Analytic-Areis/Quadrature-Down-Converter/presentation/presentation.pdf

# Design, Simulation, and Hardware Implementation of a Quadrature Down Converter

# Comprehensive Project Report & Laboratory Verification Presentation

Katta Sri Kaushik | Lakshmi Sai Bhargav V | Kushwanth Lanka

### Department of Electrical and Computer Engineering Center for VLSI and Embedded Systems Technology (CVEST) International Institute of Information Technology, Hyderabad

# May 2026

Katta, Lakshmi, Kushwanth (IIIT Hyderabad) | Quadrature Down Converter | May 2026 | 1 / 1

# Presentation Outline

Katta, Lakshmi, Kushwanth (IIIT Hyderabad) | Quadrature Down Converter | May 2026 | 2 / 1

# System Specifications & Design Constraints

# Project Performance Requirements & Directives

# Technology Node & Models: TSMC 180nm CMOS technology for

NMOS switches and UA741 operational amplifiers.

# MOSFET Parasitic Modeling: Geometric layout parameter

optimization: W , L, AS , AD, PS , PD.

# Amplifier Architecture Choice: Implemented a discrete CE BJT Amplifier stage with emitter degeneration for low-distortion output

voltage gain.

# Oscillator Target: Quadrature vOSC I & vOSC Q at 170 kHz with

90◦ phase shift and 1 Vpp swing.

# Filter & Output Spec: Cascaded LPF cutoff fc ≈ 4.65 kHz, final

amplified IF output ≥ 400 mVpp at 5 kHz.

Katta, Lakshmi, Kushwanth (IIIT Hyderabad) | Quadrature Down Converter | May 2026 | 3 / 1

# Utility & Need for Quadrature (I-Q) Operation

# Need in Wireless Receivers (Bluetooth, Wi-Fi, WLAN, 5G):

## Modern digital modulation (QAM, PSK) transmits complex vector signals: s(t) = I(t) cos(2πfc t) − Q(t) sin(2πfc t)

## Doubles spectral bandwidth efficiency compared to real-only

modulation.

# Image Rejection Without Off-Chip RF Filters:

## Direct-conversion / low-IF receivers reject image frequencies via 90◦

phase cancellation, enabling 100% CMOS single-chip integration.

# Solving the Negative Frequency Overlap Problem:

## Real-only mixing with cos(ωc t) causes upper and lower sidebands to fold onto each other. Quadrature mixing uniquely separates magnitude

and phase.

Katta, Lakshmi, Kushwanth (IIIT Hyderabad) | Quadrature Down Converter | May 2026 | 4 / 1

# QDC System Architecture & Mathematical Derivations

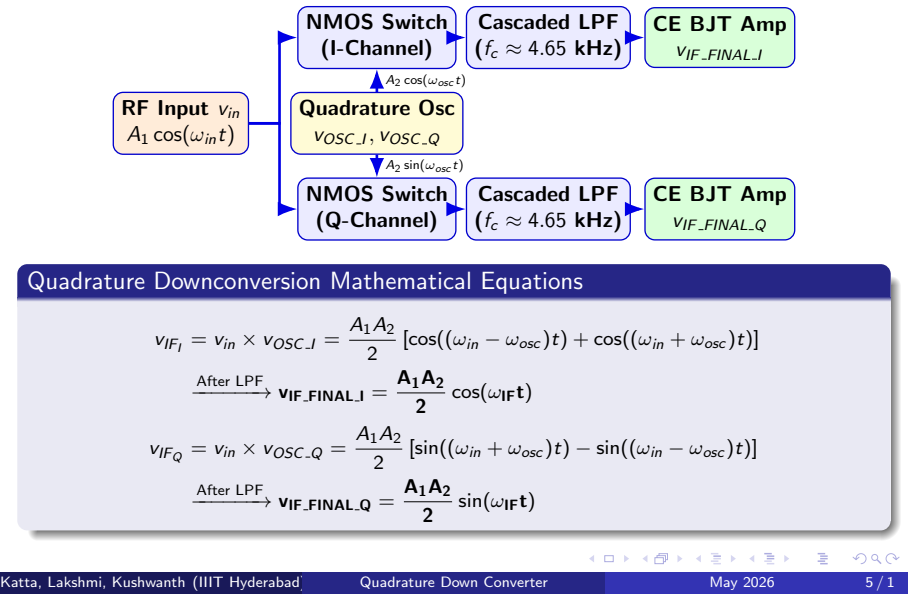
[picture p66: figure]
RF Input vin A1 cos(ωint); NMOS Switch (I-Channel); NMOS Switch (Q-Channel); Quadrature Osc; vOSC I , vOSC Q; Cascaded LPF (fc ≈ 4.65 kHz); CE BJT Amp; vIF FINAL I; vIF FINAL Q; A2 cos(ωosc t); A2 sin(ωosc t); vIFI = vin × vOSC I =; After LPF −−−−−−→ vIF FINAL I =; cos(ωIFt); vIFQ = vin × vOSC Q =; After LPF −−−−−−→ vIF FINAL Q =; sin(ωIFt); Katta, Lakshmi, Kushwanth (IIIT Hyderabad); Quadrature Down Converter; May 2026

## Quadrature Downconversion Mathematical Equations

### [cos((ωin − ωosc )t) + cos((ωin + ωosc )t)]

### [sin((ωin + ωosc )t) − sin((ωin − ωosc )t)]

# Quadrature Oscillator Topology Selection

## 3-Op-Amp Allpass Quadrature Topology:

## Consists of two active allpass filter stages and one inverting amplifier

with soft nonlinear feedback.

## Why 3-Op-Amp Allpass over 2-Op-Amp Integrator?

## Wide Bandwidth: Allpass filters maintain unity gain (G = 1) across high frequencies up to tens of

MHz.

## Precise Quadrature: Sampling between identical stages guarantees

an exact 90◦ phase shift.

## Amplitude Stability: Uniform loop gain prevents envelope variation

during frequency adjustments.


Allpass Quadrature Oscillator Block Diagram.

Katta, Lakshmi, Kushwanth (IIIT Hyderabad) | Quadrature Down Converter | May 2026 | 6 / 1

# Oscillator Derivations & Component Calculations

## Allpass Phase Shift Transfer Function: H(s) = sRC − 1 sRC + 1

## =⇒ ϕ(f ) = −2 arctan(2πfRC)

## Quadrature Oscillation Condition (ϕ = −90◦ per stage):

## 2πfoscRC = 1 =⇒ fosc =

1

## 2πRC Component Calculations for Target Frequencies (C = 27 pF):

## For fosc = 150 kHz: R =

1
2π(150 k)(27 p) ≈ 39.3 kΩ

## For fosc = 200 kHz: R =

1
2π(200 k)(27 p) ≈ 29.5 kΩ

## Supply Voltages (VDD, VSS ): ±15 V supplies provide wide linear operating range for standard UA741 op-amps to yield the requested 1 Vpp

(500 mVpeak) swing.

Katta, Lakshmi, Kushwanth (IIIT Hyderabad) | Quadrature Down Converter | May 2026 | 7 / 1

# Diode Feedback & Asymmetry Justification

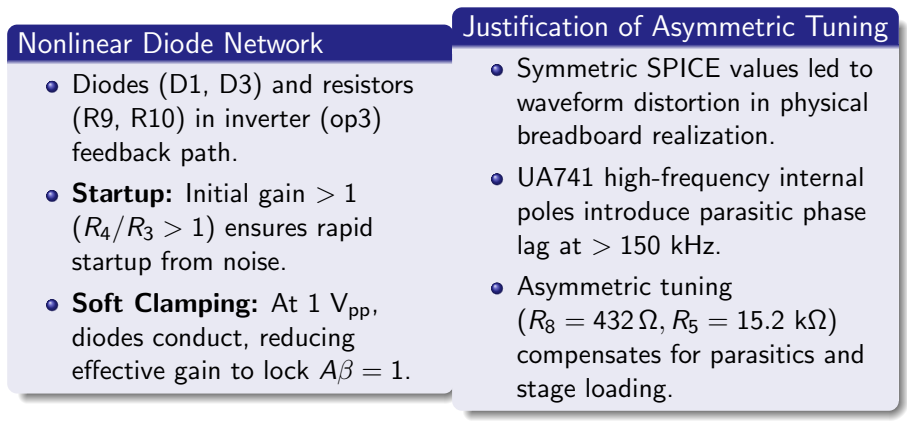
[picture p67: figure]
Nonlinear Diode Network; Diodes (D1, D3) and resistors (R9, R10) in inverter (op3) feedback path.; Startup: Initial gain > 1 (R4/R3 > 1) ensures rapid startup from noise.; Soft Clamping: At 1 Vpp, diodes conduct, reducing effective gain to lock Aβ = 1.; Justification of Asymmetric Tuning; Symmetric SPICE values led to waveform distortion in physical breadboard realization.; UA741 high-frequency internal poles introduce parasitic phase lag at > 150 kHz.; Asymmetric tuning (R8 = 432 Ω, R5 = 15.2 kΩ) compensates for parasitics and stage loading.

Katta, Lakshmi, Kushwanth (IIIT Hyderabad) | Quadrature Down Converter | May 2026 | 8 / 1

# LTSpice Simulation – Schematic & Transient Waveforms

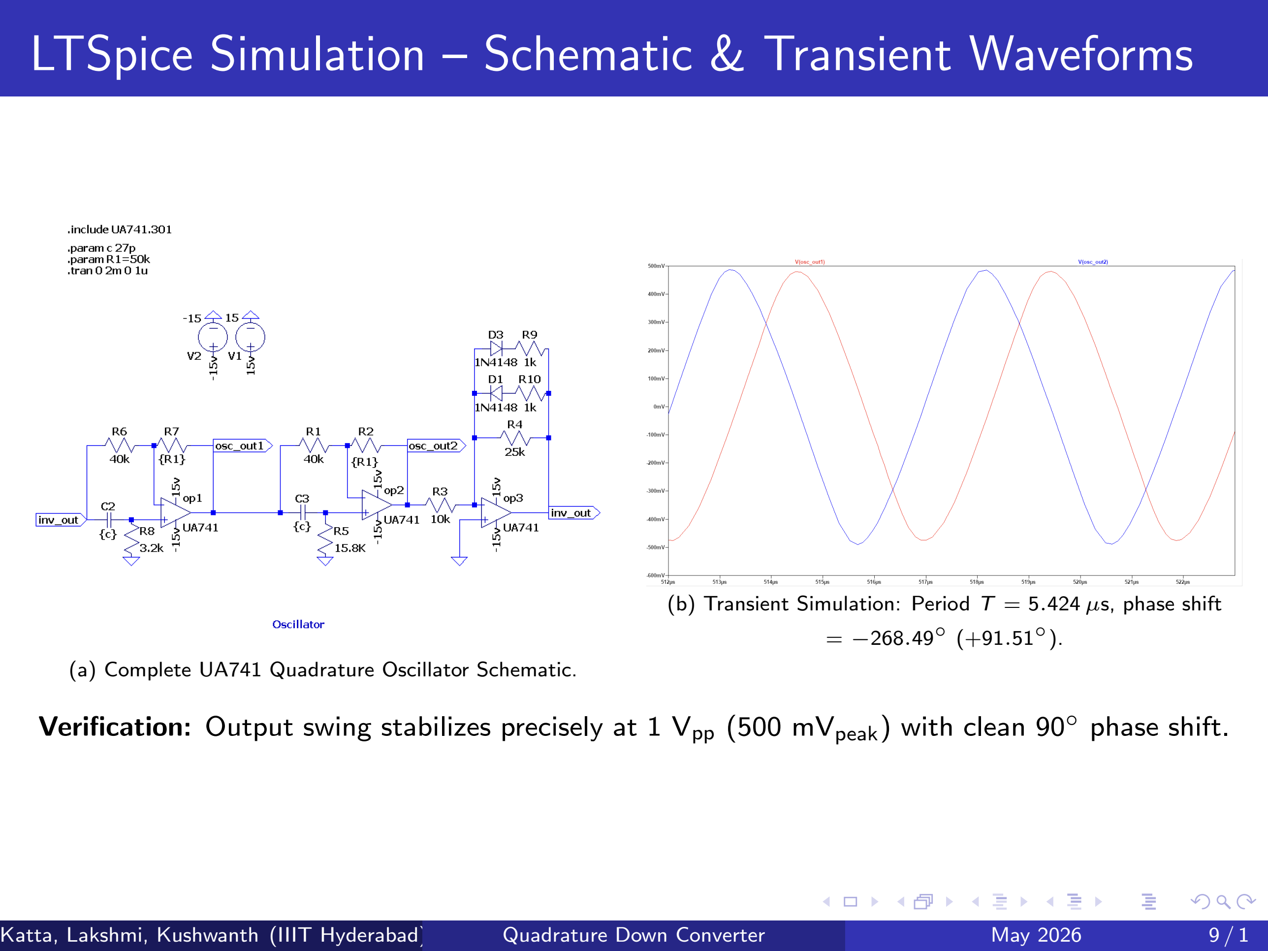
[picture p68: page 9]

(a) Complete UA741 Quadrature Oscillator Schematic.
(b) Transient Simulation: Period T = 5.424 µs, phase shift = −268.49◦ (+91.51◦).

Verification: Output swing stabilizes precisely at 1 Vpp (500 mVpeak) with clean 90◦ phase shift.

Katta, Lakshmi, Kushwanth (IIIT Hyderabad) | Quadrature Down Converter | May 2026 | 9 / 1

# Phase Measurement & FFT Spectral Analysis

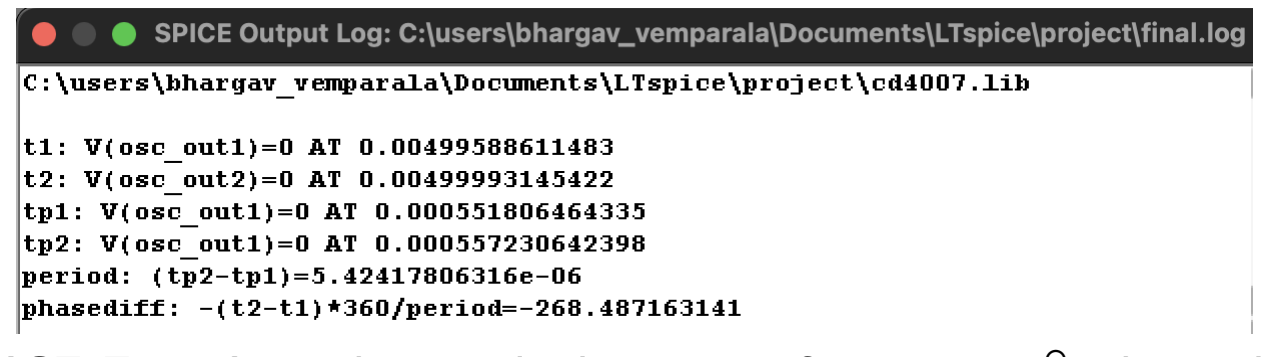
[picture p69: figure]

SPICE Error Log phase calculation verifying 91.51◦ phase shift

between I and Q.

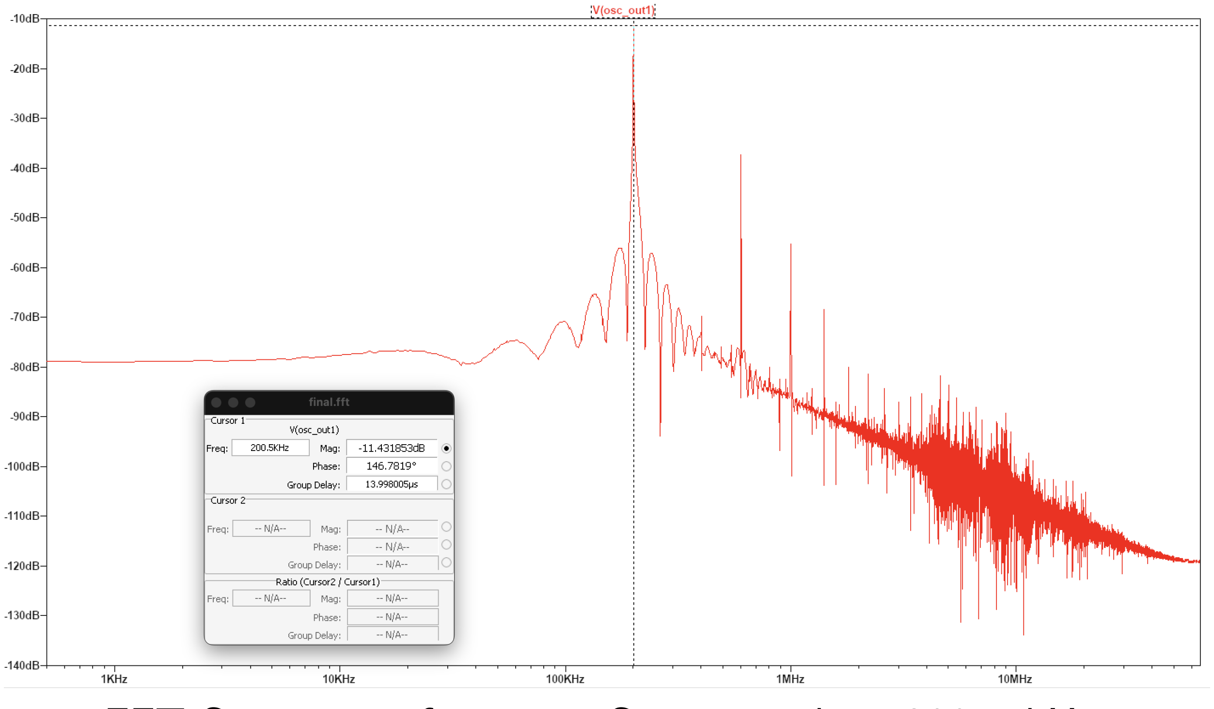
[picture p70: figure]

FFT Spectrum of vOSC I

: Strong peak at 200.5 kHz, magnitude −11.43 dB, phase 146.78◦.

Katta, Lakshmi, Kushwanth (IIIT Hyderabad) | Quadrature Down Converter | May 2026 | 10 / 1

# Hardware Realization (741 ICs) & Parameter Tweaks

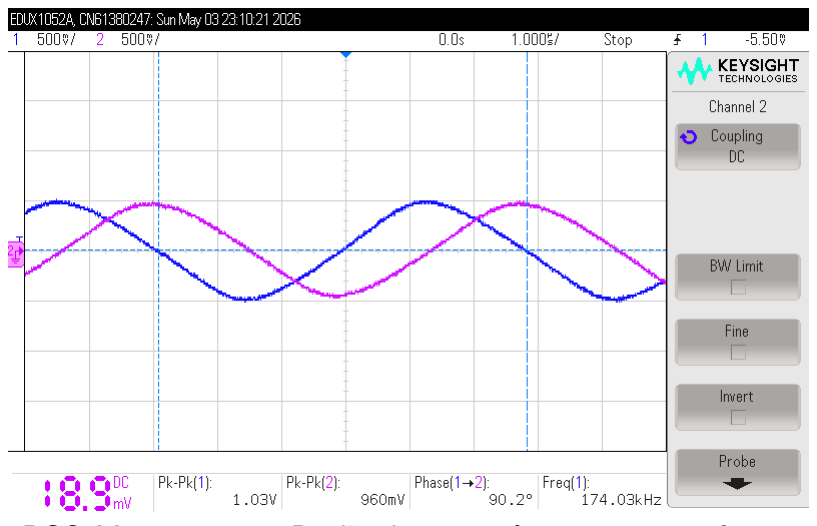
[picture p71: figure]

DSO Measurement: Realized vOSC I & vOSC Q waveforms.

Table: Resistor Comparison: SPICE vs.

## Lab Potentiometer Method

Component | SPICE Value (Ω) | Real Life Value (Ω)
R1/R7 | 40 k/50 k | 50 k/47 k
R2/R6 | 50 k/40 k | 47 k/39.2 k
R3/R4 | 10 k/25 k | 10 k/17.6 k
R5/R8 | 15.8 k/3.2 k | 15.2 k/432
R9/R10 | 1 k/1 k | 2.2 k/2.2 k

DSO FFT


confirming hardware spectral purity.

Katta, Lakshmi, Kushwanth (IIIT Hyderabad) | Quadrature Down Converter | May 2026 | 11 / 1

# Switch (Mixer) Topology & MOSFET Optimization

# Active NMOS Switch Topology: Passive NMOS switch operating

in deep triode region.

## RF Input (vin = 100 mV) connected to Drain; LO (vOSC ) AC-coupled

to Gate.
Intermediate Frequency output (vIF ) taken at Drain across RL = 1 kΩ.

# MOSFET Parameter Optimization (180 nm CMOS Node):

Channel Length: L = 0.18 µm (minimum feature size).

## Width W = 20 µm for target Ron ≈ 50 Ω (VGS − Vth = 0.6 V):

W
L

=

1

Ron · µnCox(VGS − Vth)

=

1
50 · 300 µ · 0.6

≈ 111.1

## =⇒ W = 111.1 × 0.18 µm ≈ 20 µm

# LTspice Geometric Parasitics (Y = 0.18 µm):

## Source/Drain Area: AS = AD = W × Y = 3.6 p (3.6p) Source/Drain Perimeter: PS = PD = W + 2Y = 20.36 µm (20.36u)

Katta, Lakshmi, Kushwanth (IIIT Hyderabad) | Quadrature Down Converter | May 2026 | 12 / 1

# Mixer LTSpice Schematic & Component Values


LTSpice NMOS Switch Mixer Schematic.

## Table: Mixer Component Summary

Component | Value | Rationale
M1 | NMOS (20u/0.18u) | Core switching element.
RBIAS | 10 MΩ | Prevents AC loading on LO gate
| | node.
CC | 10 nF | AC couples LO signal; blocks DC.
RL | 1 kΩ | Standard load for gain/bandwidth
| | balance.
VBIAS | 0.6 V − 0.8 V | Sets gate near Vth | for sharp
| | switching.
Katta, Lakshmi, Kushwanth (IIIT Hyderabad) | Quadrature Down Converter | May 2026 | 13 / 1

# Mixer Mathematical Derivations & Downconversion

# Square-Wave Switching Expansion:

s(t) = 1
2

+

2
π

X∞

n=1,3,5...

# sin(nωosct)

n

# Product-to-Sum Multiplication:

# vout(t) ≈ Ain cos(ωint) ·

2
π

# sin(ωosct)

=

### Ain

π

# [sin((ωosc − ωin)t) + sin((ωosc + ωin)t)]

# Extracted Frequencies (fosc = 170 kHz, fin = 165 kHz):

## Downconverted IF Component: fIF = |fosc − fin| = |170 k − 165 k| = 5 kHz Sum Component (Filtered by LPF): fsum = 170 k + 165 k = 335 kHz

Katta, Lakshmi, Kushwanth (IIIT Hyderabad) | Quadrature Down Converter | May 2026 | 14 / 1

# Frequency Sweep Analysis (fIN < fOSC: 165–169 kHz)

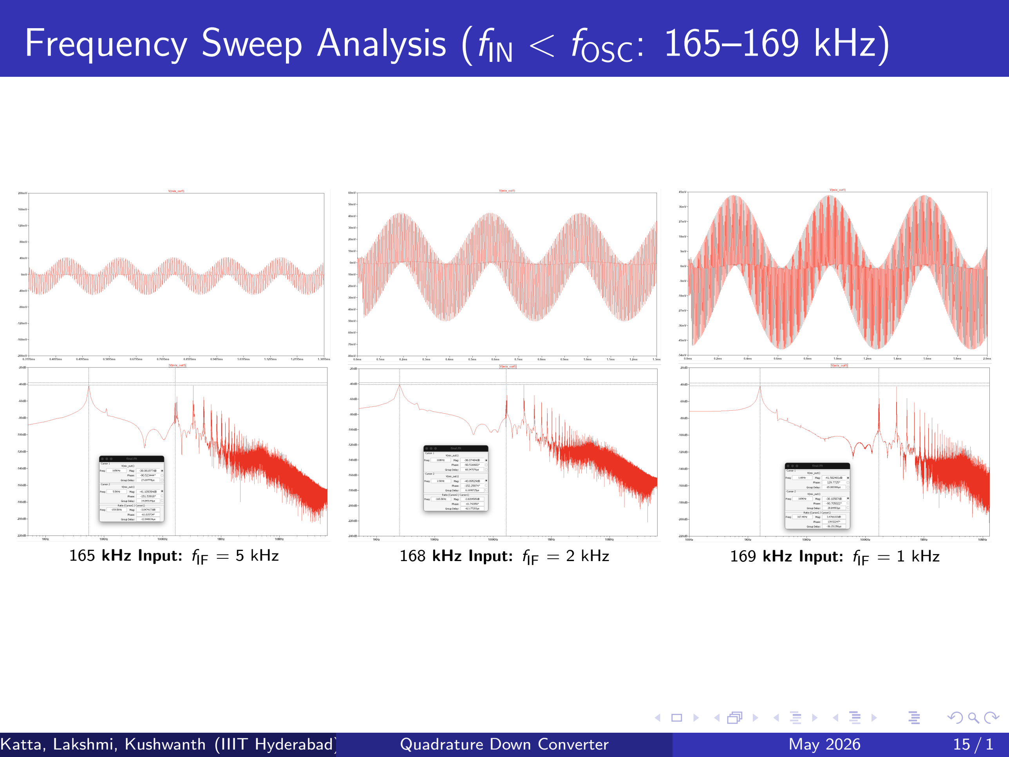
[picture p72: page 15]

165 kHz Input: fIF = 5 kHz | 168 kHz Input: fIF = 2 kHz | 169 kHz Input: fIF = 1 kHz
Katta, Lakshmi, Kushwanth (IIIT Hyderabad) | Quadrature Down Converter | May 2026 | 15 / 1

# Frequency Sweep Analysis (fIN > fOSC: 171–175 kHz)

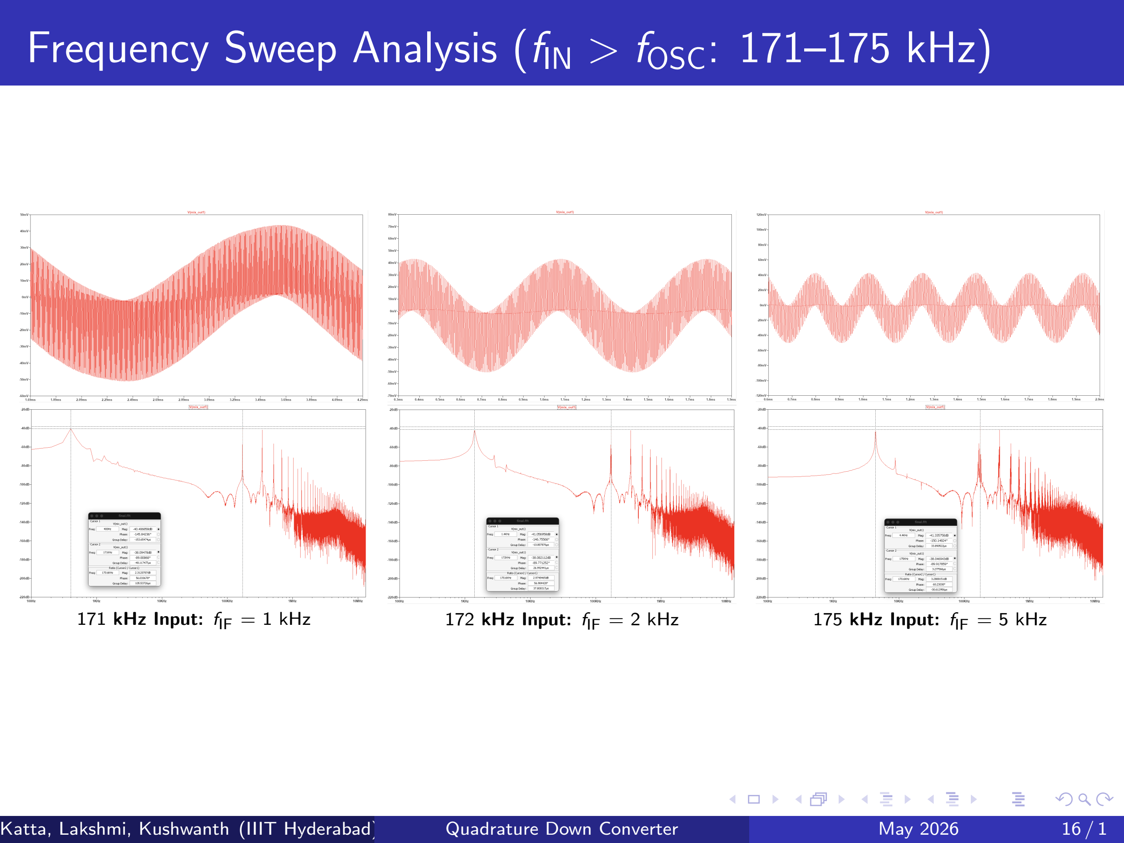
[picture p73: page 16]

171 kHz Input: fIF = 1 kHz | 172 kHz Input: fIF = 2 kHz | 175 kHz Input: fIF = 5 kHz
Katta, Lakshmi, Kushwanth (IIIT Hyderabad) | Quadrature Down Converter | May 2026 | 16 / 1

# Mixer Lab Realization & DSO Waveform Captures

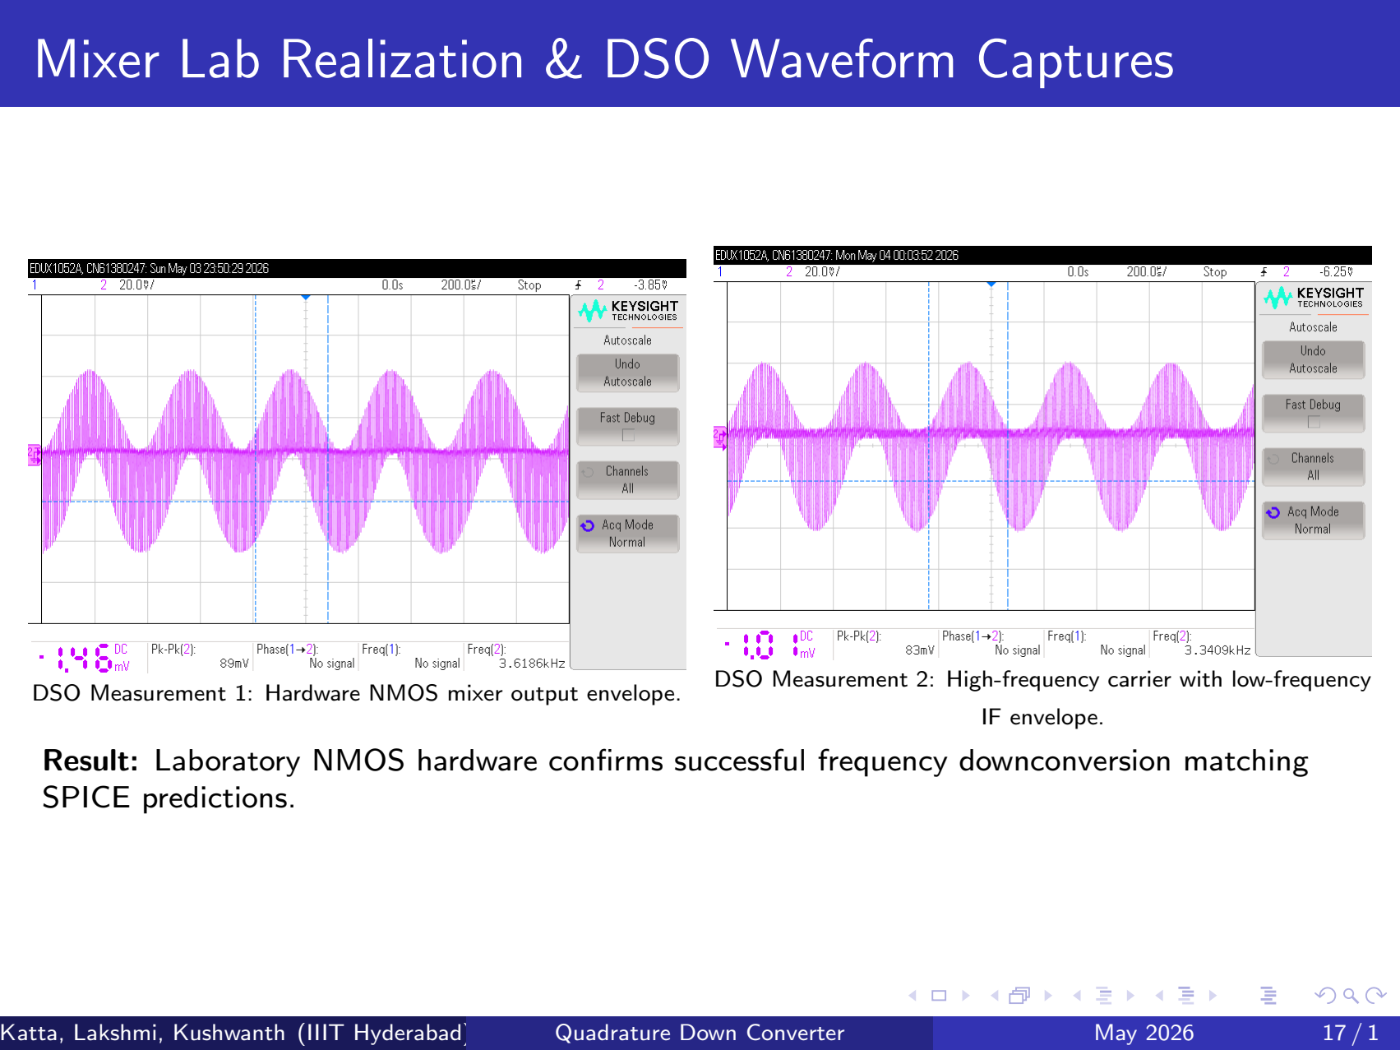
[picture p74: page 17]

DSO Measurement 1: Hardware NMOS mixer output envelope. | DSO Measurement 2: High-frequency carrier with low-frequency
| IF envelope.

### Result: Laboratory NMOS hardware confirms successful frequency downconversion matching

SPICE predictions.

Katta, Lakshmi, Kushwanth (IIIT Hyderabad) | Quadrature Down Converter | May 2026 | 17 / 1

# Low-Pass RC Filter Design & Cutoff Calculations

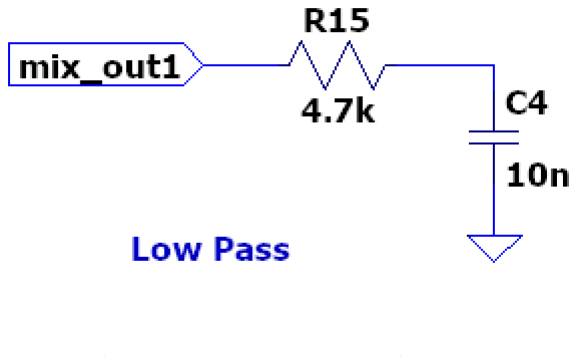
[picture p75: figure]

First-Order RC Low-Pass Filter Schematic.

# Cutoff Frequency Formula:

fc =

1

# 2πRC

# Lab Practical Implementation:

## R = 4.7 kΩ, C = 10 nF

fc =

1
2π(4700)(10 n) ≈ 3.39 kHz

# Theoretical 3 kHz Target Resistor:

### Rideal =

1

# 2π(3000)(10 nF)

≈ 5.3 kΩ

Katta, Lakshmi, Kushwanth (IIIT Hyderabad) | Quadrature Down Converter | May 2026 | 18 / 1

# LPF Optimization – 1-Stage vs. 2-Stage Cascaded LPF

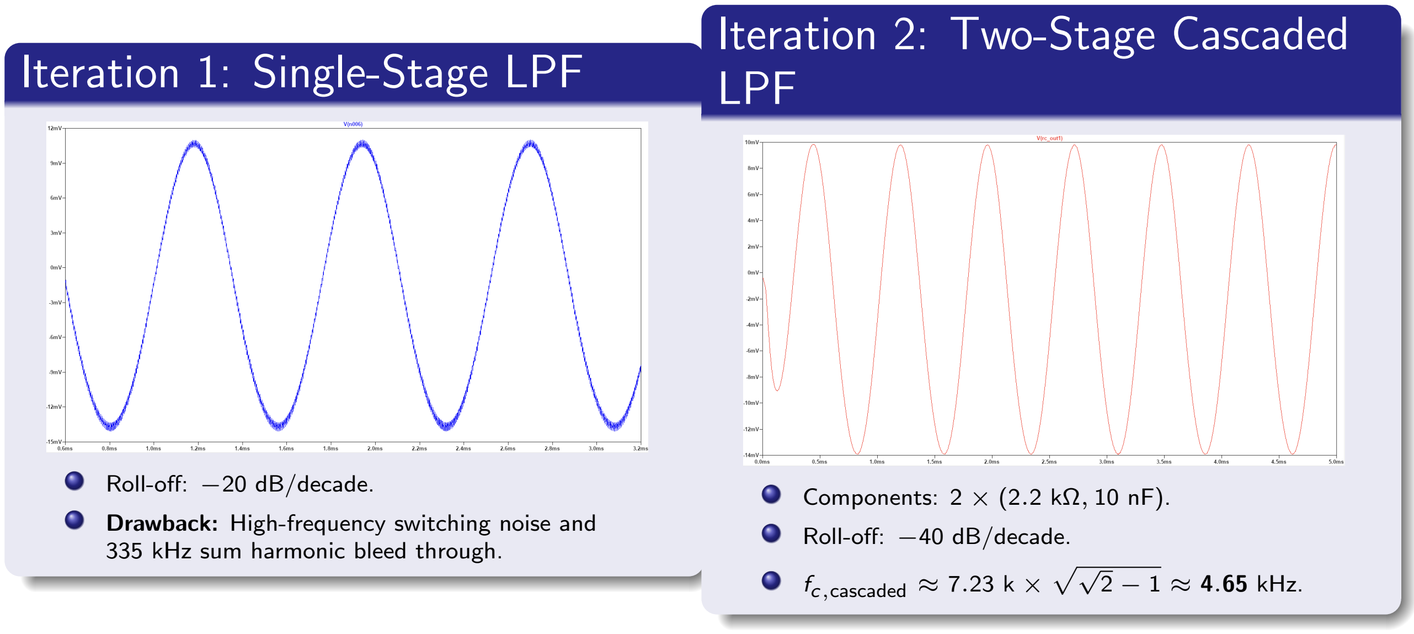
[picture p76: figure]
Iteration 1: Single-Stage LPF; Roll-off: −20 dB/decade.; Drawback: High-frequency switching noise and 335 kHz sum harmonic bleed through.; Iteration 2: Two-Stage Cascaded LPF; Components: 2 × (2.2 kΩ, 10 nF).; Roll-off: −40 dB/decade.; fc,cascaded ≈ 7.23 k ×; p√ 2 − 1 ≈ 4.65 kHz.

Katta, Lakshmi, Kushwanth (IIIT Hyderabad) | Quadrature Down Converter | May 2026 | 19 / 1

# LPF Hardware Bode Plot & Transient Response

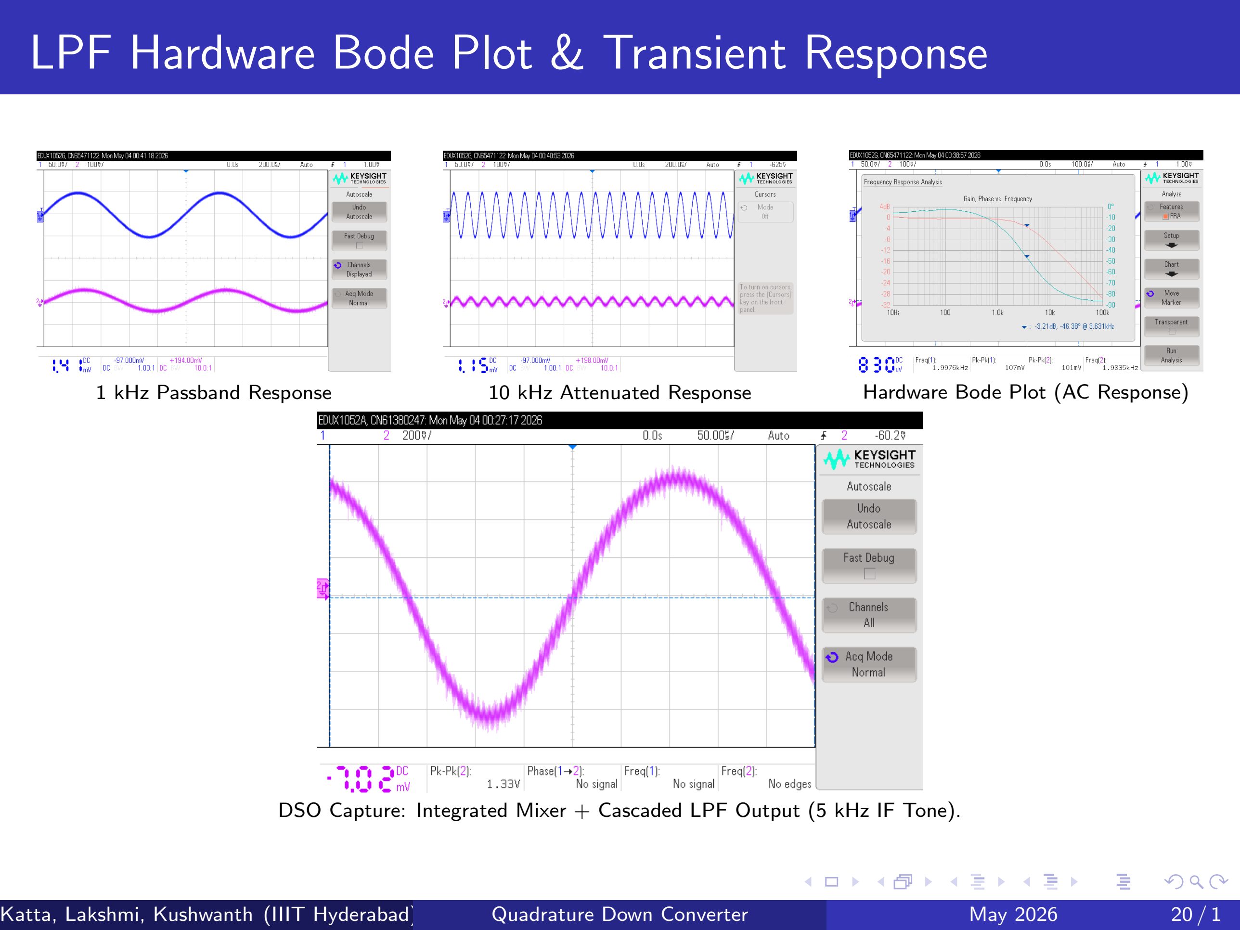
[picture p77: page 20]

1 kHz Passband Response | 10 kHz Attenuated Response | Hardware Bode Plot (AC Response)

DSO Capture: Integrated Mixer + Cascaded LPF Output (5 kHz IF Tone).

Katta, Lakshmi, Kushwanth (IIIT Hyderabad) | Quadrature Down Converter | May 2026 | 20 / 1

# CE BJT Amplifier Design (Discrete Gain Stage)

# Amplifier Topology Selection: Implemented a discrete Common

Emitter (CE) BJT Amplifier for output signal boosting.

# Problem Statement: Filter attenuation reduces 5 kHz IF to

∼ 8 mV. Target specification requires ≥ 400 mVpp.

# Emitter Degeneration (RE1 = 15 Ω) for Low THD:

# IE ≈ 1.46 mA =⇒ re =

VT
IE

≈

26 mV
1.46 mA

≈ 17.8 Ω

Av ≈

RC

# RE1 + re

=

2000
15 + 17.8

≈ 61

# Vout = Vin × Av ≈ 8 mV × 61 ≈ 488 mVpp

# Result: 488 mVpp swing comfortably satisfies the ≥ 400 mVpp

specification.

Katta, Lakshmi, Kushwanth (IIIT Hyderabad) | Quadrature Down Converter | May 2026 | 21 / 1

# Amplifier Lab Setup & Output Swing

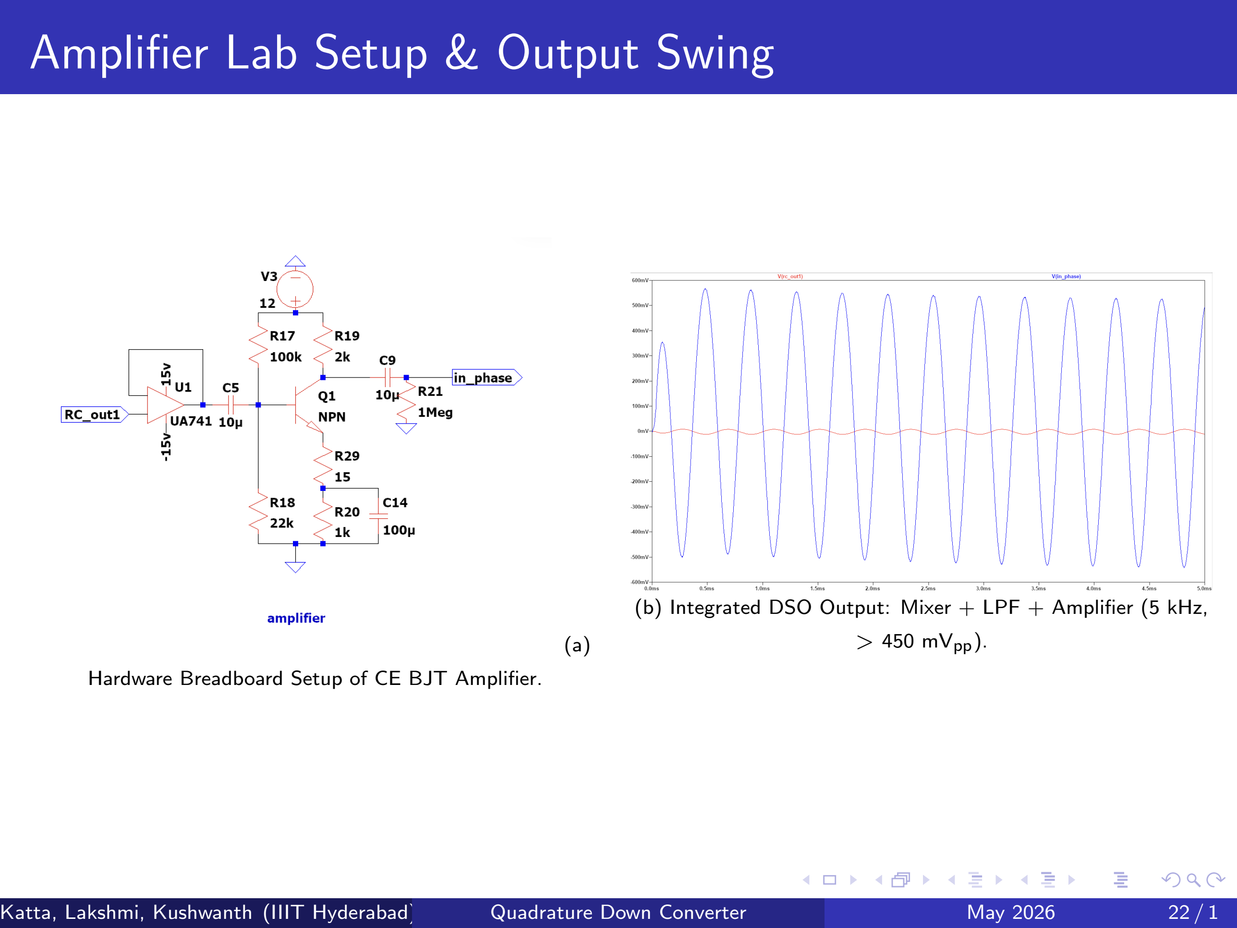
[picture p78: page 22]

(a)

Hardware Breadboard Setup of CE BJT Amplifier.

(b) Integrated DSO Output: Mixer + LPF + Amplifier (5 kHz,

> 450 mVpp).

Katta, Lakshmi, Kushwanth (IIIT Hyderabad) | Quadrature Down Converter | May 2026 | 22 / 1

# Complete Integrated QDC Prototype Schematic


### Complete QDC architecture integrating Quadrature Oscillator, dual NMOS Mixers, dual

Cascaded LPFs, and dual CE BJT Amplifiers.

Katta, Lakshmi, Kushwanth (IIIT Hyderabad) | Quadrature Down Converter | May 2026 | 23 / 1

# System LTSpice Simulation Results

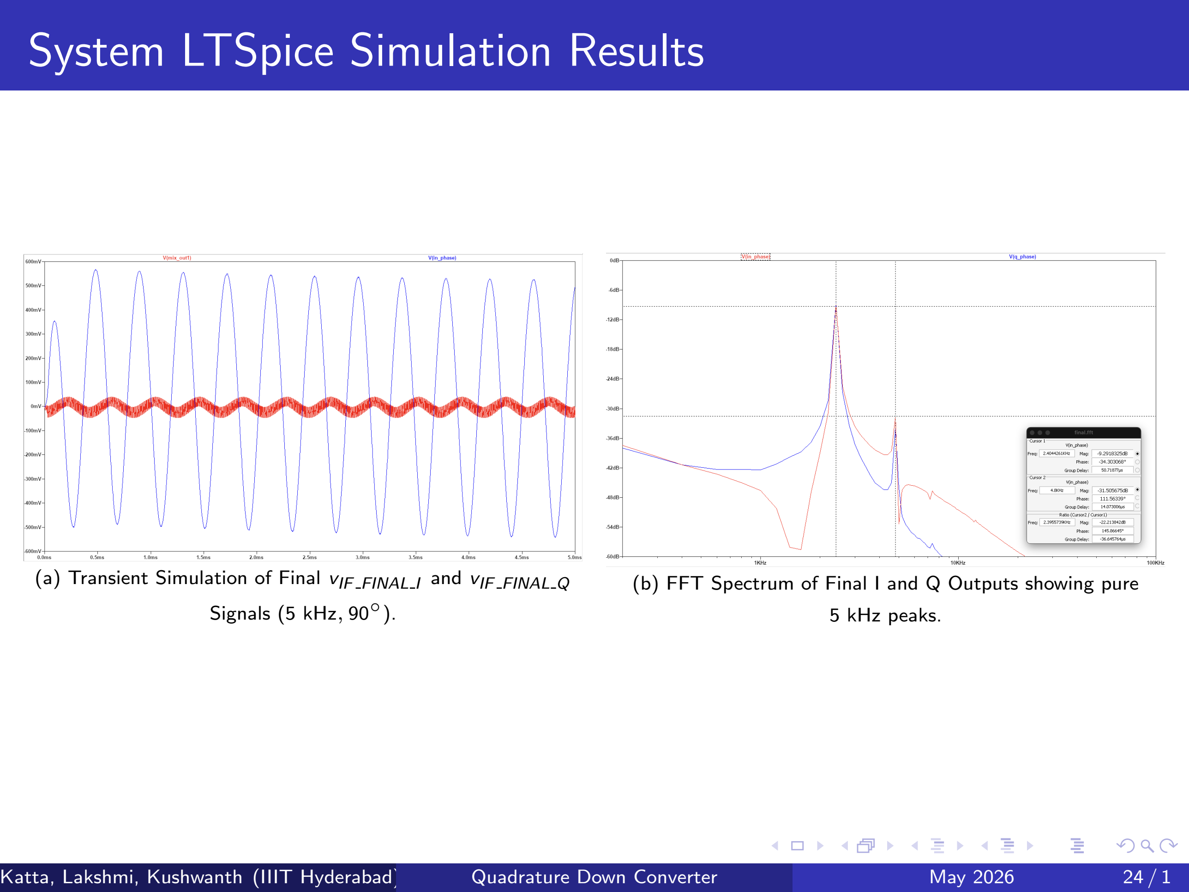
[picture p79: page 24]

(a) Transient Simulation of Final vIF FINAL I and vIF FINAL Q Signals (5 kHz, 90◦).
(b) FFT Spectrum of Final I and Q Outputs showing pure

5 kHz peaks.

Katta, Lakshmi, Kushwanth (IIIT Hyderabad) | Quadrature Down Converter | May 2026 | 24 / 1

# Hardware DSO Measurements – Single & Envelope

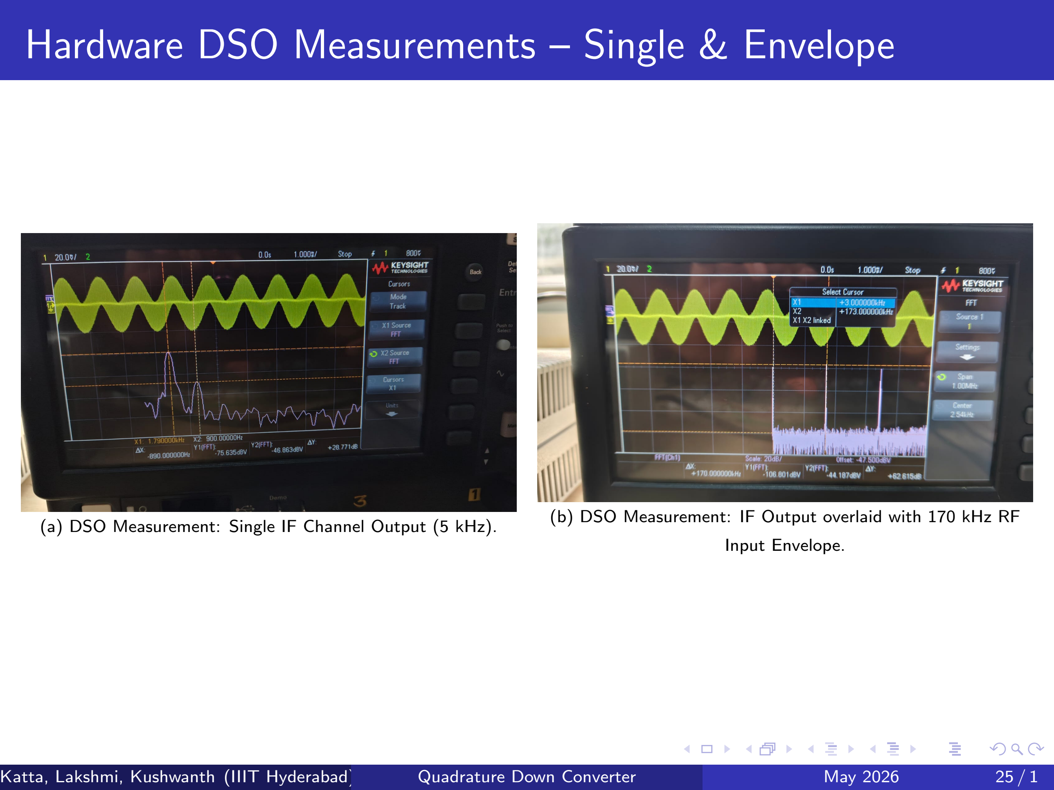
[picture p80: page 25]

(a) DSO Measurement: Single IF Channel Output (5 kHz). | (b) DSO Measurement: IF Output overlaid with 170 kHz RF
| Input Envelope.
Katta, Lakshmi, Kushwanth (IIIT Hyderabad) | Quadrature Down Converter | May 2026 | 25 / 1

# Hardware Quadrature Phase Shift Verification

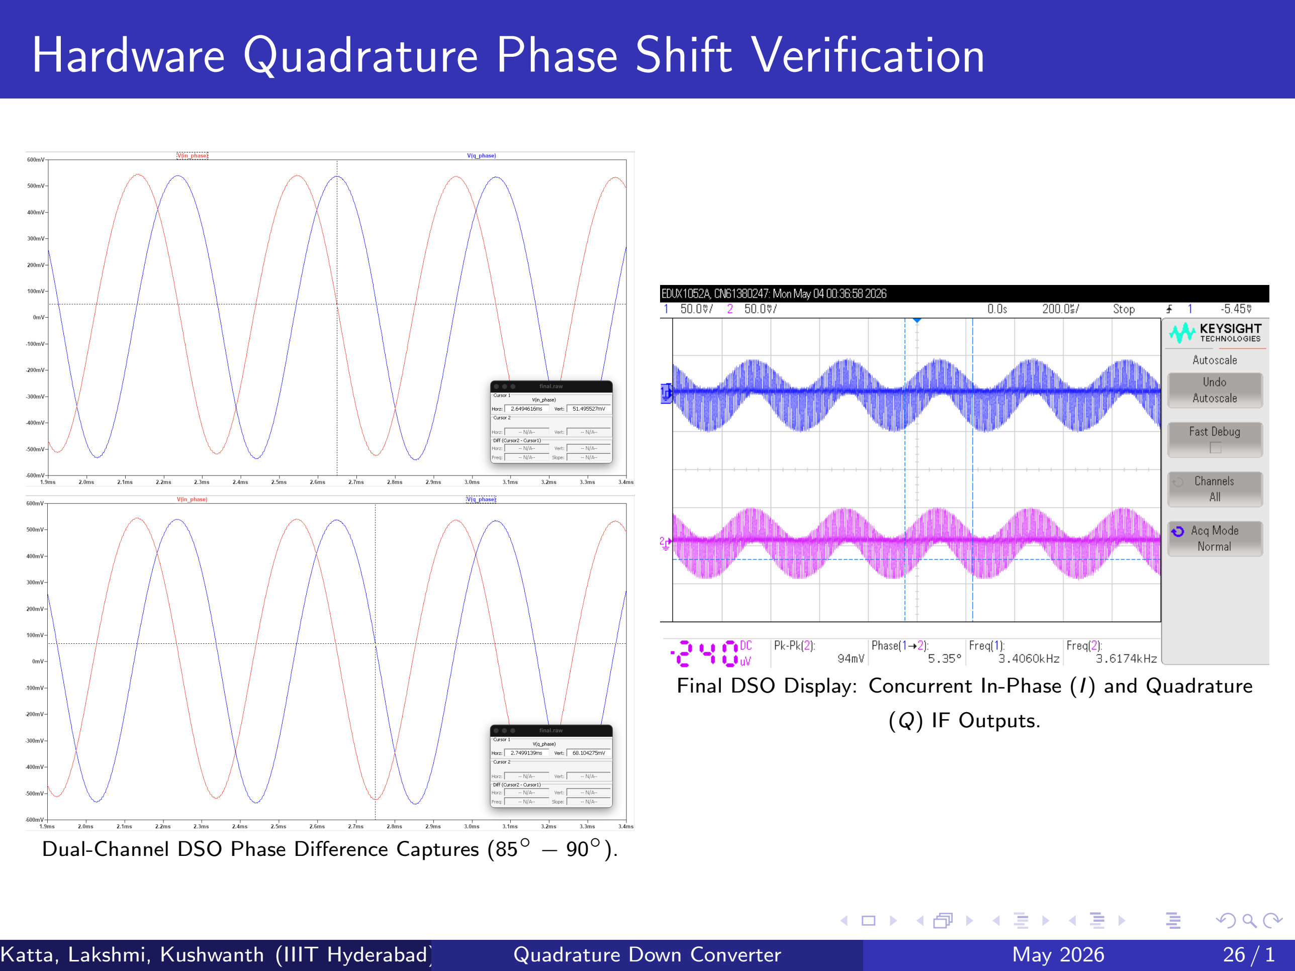
[picture p81: page 26]

Dual-Channel DSO Phase Difference Captures (85◦ − 90◦).

Final DSO Display: Concurrent In-Phase (I ) and Quadrature

(Q) IF Outputs.
Katta, Lakshmi, Kushwanth (IIIT Hyderabad) | Quadrature Down Converter | May 2026 | 26 / 1

# Performance Summary & Quantitative Comparison

## Table: System Performance Summary: Simulated vs. Measured

Parameters | Simulated | Measured
Oscillator Frequency (fosc) | 200 kHz | 174 kHz
Oscillator Amplitude (I-phase) | 500 mVpeak | 430 mVpeak
Oscillator Amplitude (Q-phase) | 500 mVpeak | 515 mVpeak
Input frequency (fin) | 202 kHz | 171 kHz
Intermediate Frequency (fIF) | 2 kHz | 3 kHz − 5 kHz
Supply Voltages | ±15 V | ±12 V
Mixer Gate Bias (VBIAS) | 1.2 V | 1.2 V
Mixer Coupling Cap (CC ) | 10 nF | 10 µF
Phase Difference (I vs Q) | 93◦ | 85◦
Final IF Amplitude (VIF FINAL) | 1.3 Vpp | 800 mVpp (≥ 400 mVspec)
LPF Components (R, C) | 4.7 kΩ, 10 nF | 2 × (2.2 kΩ, 10 nF)
Katta, Lakshmi, Kushwanth (IIIT Hyderabad) | Quadrature Down Converter | May 2026 | 27 / 1

# Conclusion & Group Member Contributions

# Project Accomplishments

# Full implementation and laboratory verification of an analog Quadrature Down Converter operating at 170 kHz with a 5 kHz IF

output.

# Successfully verified TSMC 180nm CMOS active mixer, 3-op-amp allpass quadrature oscillator, 2-stage cascaded LPF, and discrete CE

BJT amplifier stage.

# Group Member Contributions

Katta Sri Kaushik (2025102071): Quadrature Oscillator design, allpass phase calculations, diode soft limiting network tuning, and LTSpice transient/FFT simulations.

Lakshmi Sai Bhargav V (2025102061): Active NMOS switch mixer design, MOSFET sizing (W/L, AS , PS ), frequency sweep simulations, and integrated system layout.

Kushwanth Lanka (2025102072): Two-stage cascaded RC LPF optimization, CE BJT amplifier design with emitter degeneration for low THD, and physical DSO hardware testing.

Katta, Lakshmi, Kushwanth (IIIT Hyderabad) | Quadrature Down Converter | May 2026 | 28 / 1

# Thank You!

# Questions & Technical Discussion

Katta, Lakshmi, Kushwanth (IIIT Hyderabad) | Quadrature Down Converter | May 2026 | 29 / 1
