Analytic-Areis/Quadrature-Down-Converter/QDC-simulations/mixer_test.asc

C1: cap; 10µ
M1: nmos4; CMOSN; l = 0.18u w = 1
R1: res; 10Meg
R2: res; 1k
V1: voltage; SINE(0 500m 100k)
V2: voltage; 0.52
V3: voltage; SIN(0 100m 105k)
Named nets: 0, out, in
.include TSMC_180nm.txt
.tran 1m
