Analytic-Areis/Quadrature-Down-Converter/QDC-simulations/amplified_output_QDC.asc

C1: cap; 10n
C2: cap; {c}
C3: cap; {c}
C4: cap; 10n
C5: cap; 10µ
C6: cap; 10n
C7: cap; 10µ
C8: cap; 10n
C9: cap; 1µ
C10: cap; 1µ
D1: diode; 1N4148
D3: diode; 1N4148
M1: nmos4; NMOS_CD4007; L=5u W=170u Ad=8500p As=8500p Pd=440u Ps=440u NRD=0.1 NRS=0.1
M2: nmos4; NMOS_CD4007; L=5u W=170u Ad=8500p As=8500p Pd=440u Ps=440u NRD=0.1 NRS=0.1
M3: pmos4; PMOS_CD4007; L=5u W=360u Ad=18000p As=18000p Pd=820u Ps=820u NRS=0.54 NRD=0.54
M4: nmos4; NMOS_CD4007; L=5u W=170u Ad=8500p As=8500p Pd=440u Ps=440u NRD=0.1 NRS=0.1
M5: pmos4; PMOS_CD4007; L=5u W=360u Ad=18000p As=18000p Pd=820u Ps=820u NRS=0.54 NRD=0.54
M6: nmos4; NMOS_CD4007; L=5u W=170u Ad=8500p As=8500p Pd=440u Ps=440u NRD=0.1 NRS=0.1
M7: pmos4; PMOS_CD4007; L=5u W=360u Ad=18000p As=18000p Pd=820u Ps=820u NRS=0.54 NRD=0.54
M8: nmos4; NMOS_CD4007; L=5u W=170u Ad=8500p As=8500p Pd=440u Ps=440u NRD=0.1 NRS=0.1
M9: pmos4; PMOS_CD4007; L=5u W=360u Ad=18000p As=18000p Pd=820u Ps=820u NRS=0.54 NRD=0.54
M10: nmos4; NMOS_CD4007; L=5u W=170u Ad=8500p As=8500p Pd=440u Ps=440u NRD=0.1 NRS=0.1
R1: res; 40k
R2: res; {R1}
R3: res; 10k
R4: res; 44k
R5: res; 18K
R6: res; 40k
R7: res; {R1}
R8: res; 4.2k
R9: res; 1k
R10: res; 1k
R11: res; 10Meg
R12: res; 1k
R13: res; 10Meg
R14: res; 1k
R15: res; 4.7k
R16: res; 4.7k
R17: res; 4Meg
R18: res; 4Meg
R19: res; 4Meg
R20: res; 4Meg
R21: res; 1Meg
R22: res; 1Meg
U4: UA741
U5: UA741
U6: UA741
V1: voltage; 12
V2: voltage; -12
V3: voltage; 12
V4: voltage; 12
V5: voltage; SINE(0 100m {f})
V6: voltage; 1.5
V7: voltage; 12
V8: voltage; 12
Named nets: 0, 15v, -15v, out2, Vbias, Vin, IF_AMP, innode, QF_AMP, out1
.tran 0 5m 0 1u
.param R1=50k
.meas TRAN t1 WHEN V(out1)=0 RISE=last
.meas TRAN t2 WHEN V(out2)=0 RISE=last
.meas TRAN tp1 WHEN V(out1)=0 RISE=100
.meas TRAN tp2 WHEN V(out1)=0 RISE=101
.meas TRAN period PARAM (tp2-tp1)
.meas TRAN phasediff PARAM -(t2-t1)*360/period
.param c 27p
Oscillator
.include UA741.301
.include TSMC_180nm.txt
.include cd4007.lib
.step param f list 191k 195k
