Analytic-Areis/Quadrature-Down-Converter/QDC-simulations/Amplifier.asc

C2: cap; 1µ
C3: cap; 1n
M1: pmos4; PMOS_CD4007; L=5u W=360u Ad=18000p As=18000p Pd=820u Ps=820u NRS=0.54 NRD=0.54
M2: nmos4; NMOS_CD4007; L=5u W=170u Ad=8500p As=8500p Pd=440u Ps=440u NRD=0.1 NRS=0.1
R2: res; 75k
V1: voltage; AC 1
V2: voltage; 5
Named nets: 0, amp_out, in
.ac dec 1000 100 1Meg
.include cd4007.lib
