Analytic-Areis/Quadrature-Down-Converter/QDC-simulations/final.asc

C1: cap; 10n
C2: cap; {c}
C3: cap; {c}
C4: cap; 10n
C5: cap; 10µ
C6: cap; 10n
C7: cap; 10µ
C8: cap; 10n
C9: cap; 10µ
C10: cap; 10µ
C11: cap; 10n
C12: cap; 10n
C13: cap; 100µ
C14: cap; 100µ
D1: diode; 1N4148
D3: diode; 1N4148
M1: nmos4; NMOS_CD4007; L=5u W=170u Ad=8500p As=8500p Pd=440u Ps=440u NRD=0.1 NRS=0.1
M2: nmos4; NMOS_CD4007; L=5u W=170u Ad=8500p As=8500p Pd=440u Ps=440u NRD=0.1 NRS=0.1
op1: UA741
op2: UA741
op3: UA741
Q1: npn
Q2: npn
R1: res; 40k
R2: res; {R1}
R3: res; 10k
R4: res; 25k
R5: res; 15.8k
R6: res; 40k
R7: res; {R1}
R8: res; 3.2k
R9: res; 1k
R10: res; 1k
R11: res; 10Meg
R12: res; 1k
R13: res; 10Meg
R14: res; 1k
R15: res; 2.2k
R16: res; 2.2k
R17: res; 100k
R18: res; 22k
R19: res; 2k
R20: res; 1k
R21: res; 1Meg
R22: res; 100k
R23: res; 2.2k
R24: res; 2.2k
R25: res; 22k
R26: res; 2k
R27: res; 1k
R28: res; 1Meg
R29: res; 15
R30: res; 15
U1: UA741
U2: UA741
V1: voltage; 15
V2: voltage; -15
V3: voltage; 12
V4: voltage; 12
V5: voltage; SINE(0 100m 202k)
V6: voltage; 1.5
Named nets: 0, 15v, -15v, osc_out2, Vbias, Vin, osc_out1, inv_out, mix_out2, mix_out1, RC_out2, RC_out1, in_phase, q_phase
.tran 0 5m 0 1u
.param R1=50k
.meas TRAN t1 WHEN V(osc_out1)=0 RISE=last
.meas TRAN t2 WHEN V(osc_out2)=0 RISE=last
.meas TRAN tp1 WHEN V(osc_out1)=0 RISE=100
.meas TRAN tp2 WHEN V(osc_out1)=0 RISE=101
.meas TRAN period PARAM (tp2-tp1)
.meas TRAN phasediff PARAM -(t2-t1)*360/period
.param c 27p
Oscillator
.include UA741.301
.include TSMC_180nm.txt
.include cd4007.lib
-
-
-
+
+
+
Mixer
Low Pass
amplifier
