Analytic-Areis/Quadrature-Down-Converter/QDC-simulations/LPF.asc

C1: cap; 100p
R1: res; 530.5k
V1: voltage; SINE(0 1 1k)
Named nets: in, out, 0
.ac dec 100 10k 1M
.tran 5m
