Analytic-Areis/Quadrature-Down-Converter/QDC-simulations/LPF2.asc

C1: cap; 10µ
C2: cap
M1: nmos4; CMOSN; l = 0.18u w = 1 ad = 0.9p as = 0.9p pd = 2.8u ps = 2.8u
R1: res; 10Meg
R2: res; 1k
R3: res
V1: voltage; SINE(0 100m 201k)
V2: voltage; 0.5
V3: voltage; SIN(0 100m 200k)
Named nets: 0, in, out
.include opamp/TSMC_180nm.txt
.tran 10m
