Analytic-Areis/Quadrature-Down-Converter/QDC-simulations/mixer.asc

C1: cap; 10µ
M1: nmos4; NMOS_CD4007; L=5u W=170u Ad=8500p As=8500p Pd=440u Ps=440u NRD=0.1 NRS=0.1
R1: res; 1Meg
R2: res; 1k
V1: voltage; SINE(0 500m 200k)
V2: voltage; 1.5
V3: voltage; SIN(0 100m 205k)
Named nets: 0, out, in
.include opamp/TSMC_180nm.txt
.tran 1m
.ac dec 100 1k 1Meg
.include cd4007.lib
