Analytic-Areis/Quadrature-Down-Converter/QDC-simulations/QDC.asc

C2: cap; {c}
C3: cap; {c}
D1: diode; 1N4148
D3: diode; 1N4148
I1: current; AC 1
R1: res; {R1}
R2: res; {R1}
R3: res; 10k
R4: res; 44K
R5: res; 15.5K
R6: res; {R1}
R7: res; {R1}
R8: res; 4.2k
R9: res; 1k
R10: res; 1k
U1: UA741
U4: UA741
U5: UA741
U6: UA741
V1: voltage; 12
V2: voltage; -12
Named nets: 0, 15v, -15v, out1, out2
.include /Users/bhargav_vemparala/Documents/LTspice/Regulators/UA741.301
.tran 0 1m 0 1u
.param R1=50k
.ic V(n002)=0.5
.meas TRAN t1 WHEN V(out1)=0 RISE=last
.meas TRAN t2 WHEN V(out2)=0 RISE=last
.meas TRAN tp1 WHEN V(out1)=0 RISE=100
.meas TRAN tp2 WHEN V(out1)=0 RISE=101
.meas TRAN period PARAM (tp2-tp1)
.meas TRAN phasediff PARAM -(t2-t1)*360/period
.param c 27p
Oscillator
please lable all the circuits like this
.meas AC Zout1_max MAX mag(V(out1))
.meas AC Zout2_max MAX mag(V(out2))
.ac dec 100 1 1G
